Eswarnath-jeyaram/PoleSentinel/image.png

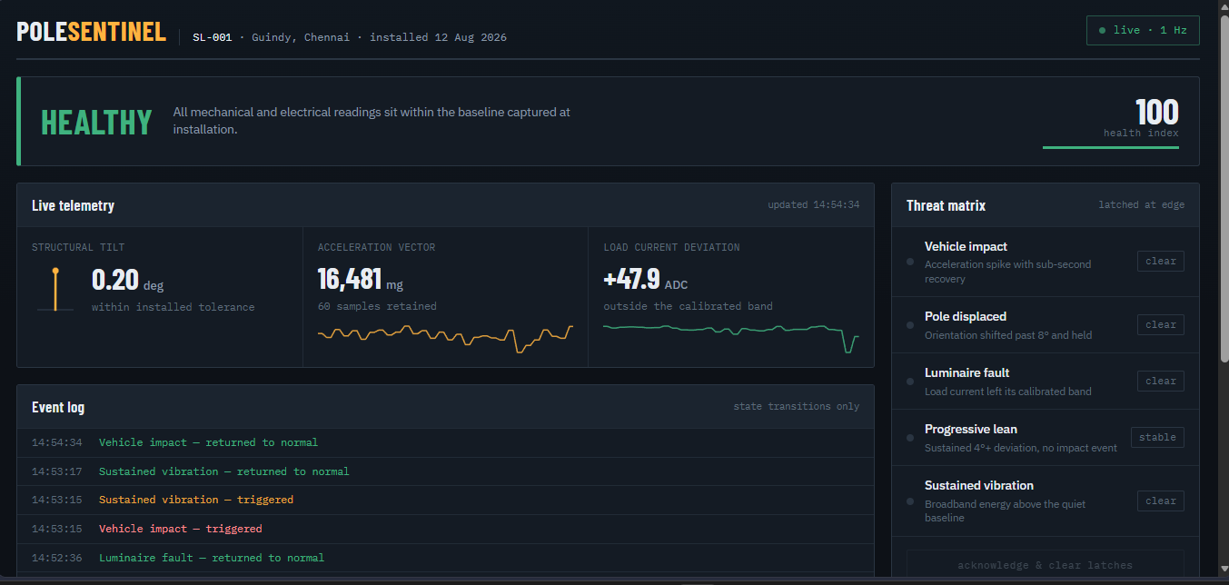
image.png
